unipartdigital/tail-anchor-hardware/README.md

# tail-anchor-hardware

Standalone anchor for tail

See https://github.com/unipartdigital/tail for more details
