unipartdigital/tail-anchor-hardware/v1/3d/ARJP11A_ARJP11A-MA.step

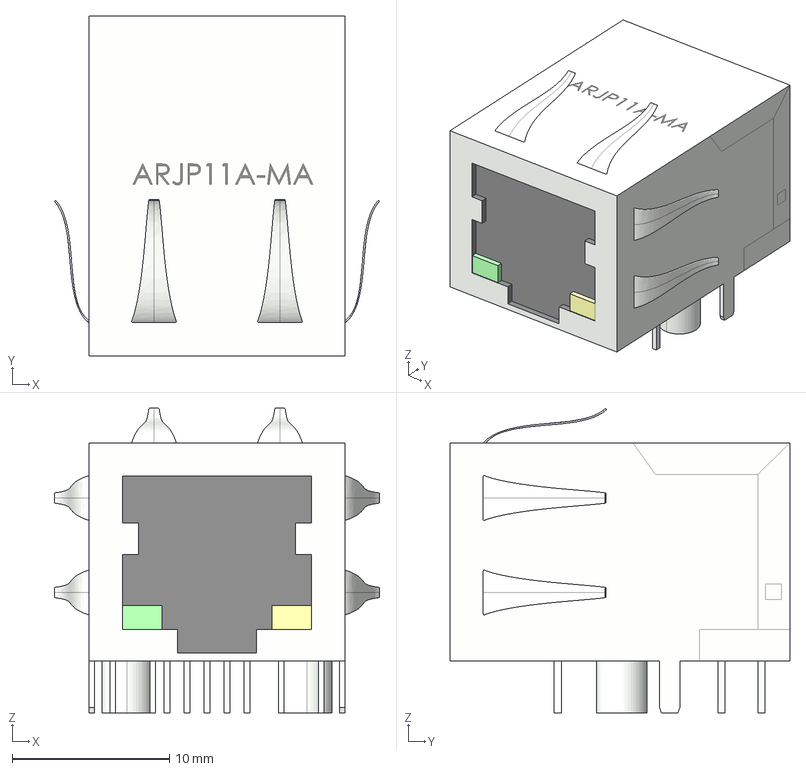
[picture p1: CAD file, 2020-07-31]
v1/3d/ARJP11A_ARJP11A-MA.step
20.7 x 21.6 x 19.3 mm
