unipartdigital/tail-anchor-hardware/(list of files, cad)

Other CAD files:
v1/3d/ARJP11A_ARJP11A-MB.step
