unipartdigital/tail-anchor-hardware/v1/tail-anchor-hardware.pdf

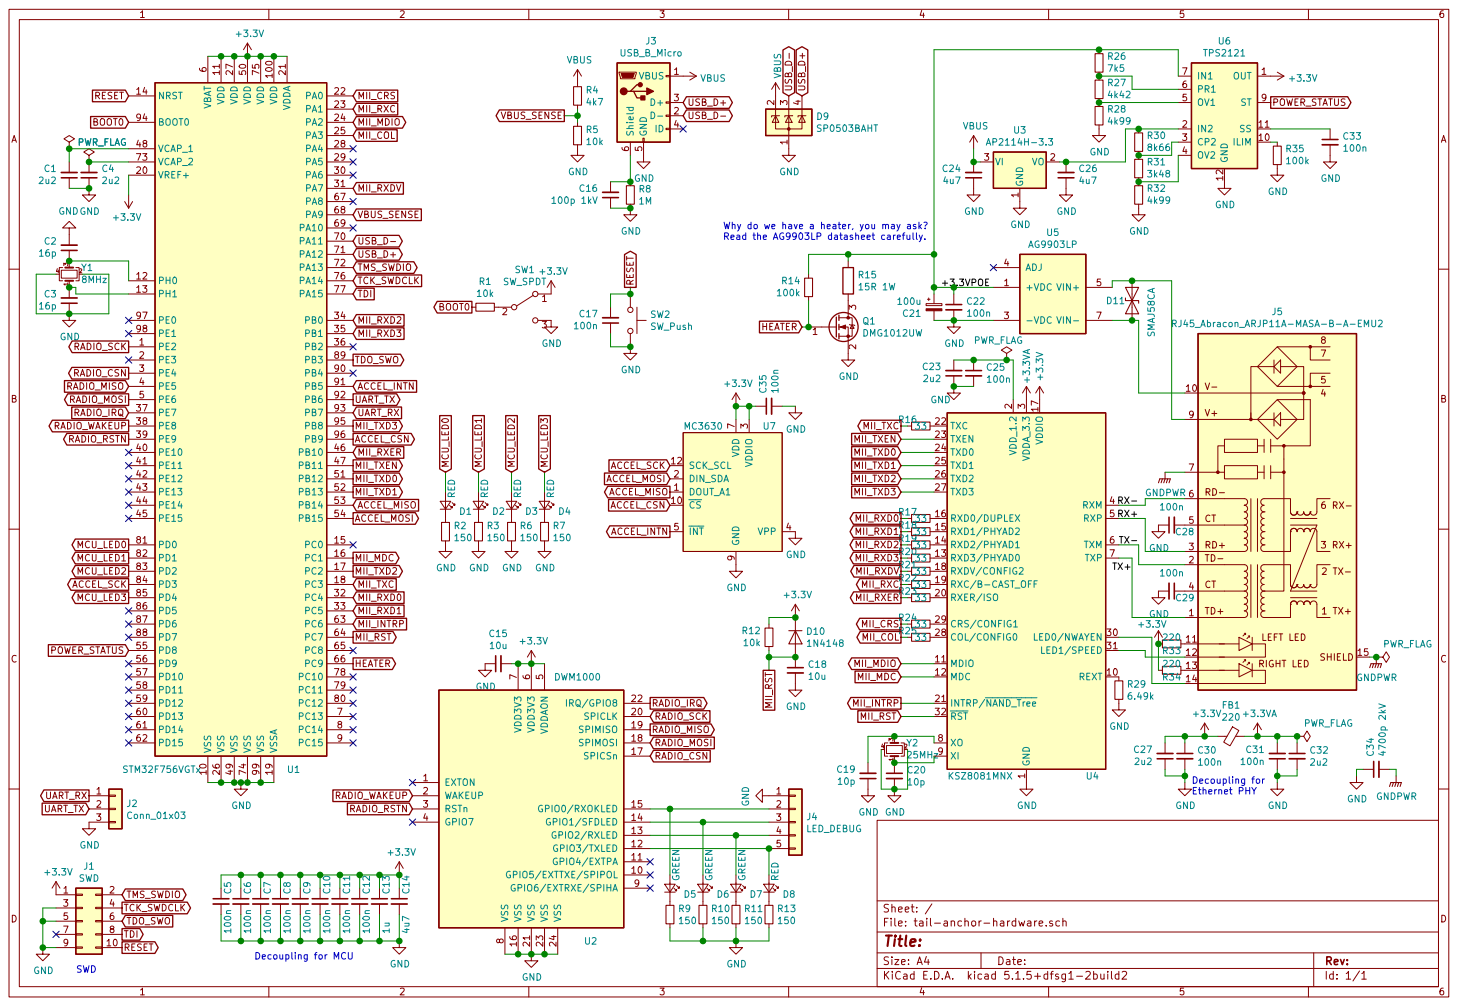
[picture p2: page 1]

6 VCAP_1 48 VCAP_2 73 VDD 100 VDD 11 VDD 27 VDD 50 VDD 75 VDDA 21 VREF+ 20 VSS 10 VSS 26 VSS 49 VSS 74 VSS 99 VSSA

Read the AG9903LP datasheet carefully.

1 REXT 10 MDIO 11 MDC 12 RXD1/PHYAD2 15 RXD0/DUPLEX 16 VDDIO 17 RXDV/CONFIG2 18 RXC/B-CAST_OFF 19 VDD_1.2

R33 12
220

Decoupling for Ethernet PHY

Id: 1/1 Title: File: tail-anchor-hardware.sch Sheet: / GND
