unipartdigital/tail-anchor-hardware/v1/tail-anchor-hardware.kicad_pcb

## KiCad design v1/tail-anchor-hardware.kicad_pcb (2020-07-31)

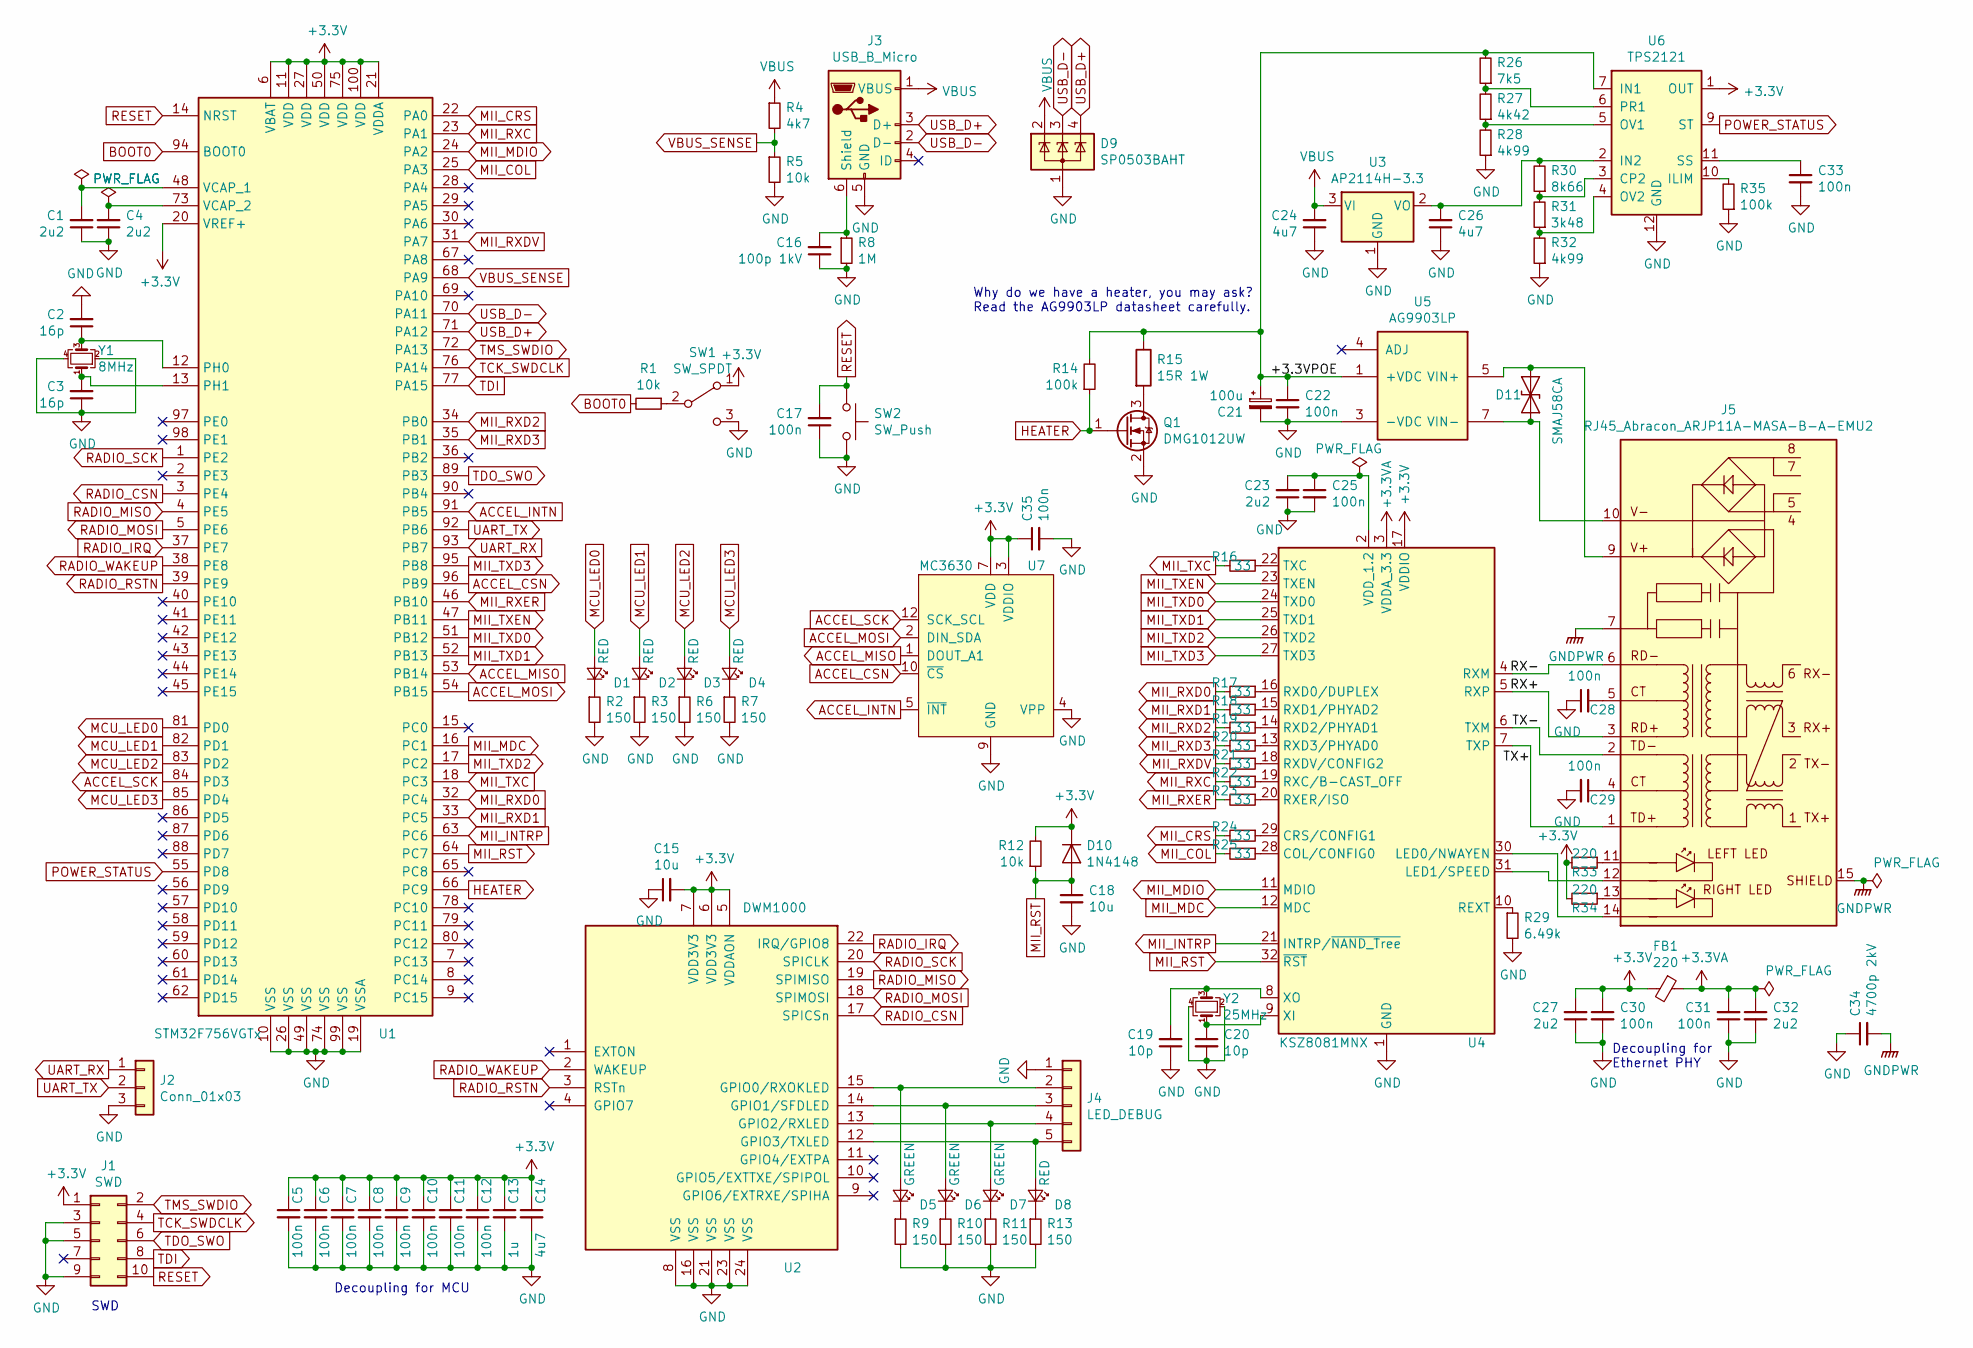
[picture p3: schematic tail-anchor-hardware.sch]

Parts:
C1, C4, C23, C27, C32: 2u2; C_0402_1005Metric; MPN GRM155R60J225ME95D
C2, C3: 16p; C_0402_1005Metric; MPN GJM1555C1H160GB01D
C5, C6, C7, C8, C9, C10, C11, C12, C17, C22, C25, C28, C29, C30, C31, C33, C35: 100n; C_0402_1005Metric; MPN MC0402X104K6R3CT
C13: 1u; C_0402_1005Metric; MPN CL05A105KQ5NNNC
C14, C24, C26: 4u7; C_0402_1005Metric; MPN GRM155R60G475ME87D
C15, C18: 10u; C_0402_1005Metric; MPN GRM155R60J106ME44D
C16: 100p 1kV; C_1206_3216Metric; MPN C1206C101JDGACAUTO
C19, C20: 10p; C_0402_1005Metric; MPN MCMT15N100F100CT
C21: 100u; C_Elec_5x5.8; MPN VZT101M1CTR-0506
C34: 4700p 2kV; C_1812_4532Metric; MPN C1812C472KGRACTU
D1, D2, D3, D4, D8: RED; LED_0603_1608Metric; MPN KP-1608SURCK
D5, D6, D7: GREEN; LED_0603_1608Metric; MPN KP-1608CGCK
D9: SP0503BAHT; SOT-143; MPN SP0503BAHTG
D10: 1N4148; D_SOD-123; MPN 1N4148W+
D11: SMAJ58CA; D_SMA; MPN SMAJ58CA
FB1: 220; L_0402_1005Metric; MPN BLM15AG221SN1D
J1: SWD; PinHeader_2x05_P1.27mm_Vertical_SMD; MPN FTSH-105-01-L-DV
J2: Conn_01x03; PinHeader_1x03_P2.54mm_Horizontal; MPN MC34747
J3: USB_B_Micro; USB_Micro-B_Molex_47346-0001; MPN 47346-0001
J4: LED_DEBUG; PinHeader_1x05_P2.54mm_Vertical; MPN 2211S-05G
J5: RJ45_Abracon_ARJP11A-MASA-B-A-EMU2; RJ45_Abracon_ARJP11A-MA_Horizontal; MPN ARJP11A-MASA-B-A-EMU2
Q1: DMG1012UW; SOT-323_SC-70; MPN DMG1012UW
R1, R5, R12: 10k; R_0402_1005Metric; MPN MCWR04X1002FTL
R2, R3, R6, R7, R9, R10, R11, R13: 150; R_0402_1005Metric; MPN MCWR04X1500FTL
R4: 4k7; R_0402_1005Metric; MPN MCWR04X4701FTL
R8: 1M; R_2010_5025Metric; MPN MCHVR0AJTEU1004
R14, R35: 100k; R_0402_1005Metric; MPN MCWR04X1003FTL
R15: 15R 1W; R_MELF_MMB-0207; MPN SMA-A0207FTDT15R
R16, R17, R18, R19, R20, R21, R22, R23, R24, R25: 33; R_0402_1005Metric; MPN CRG0402F33R
R26: 7k5; R_0402_1005Metric; MPN MCWR04X7501FTL
R27: 4k42; R_0402_1005Metric; MPN MCMR04X4421FTL
R28, R32: 4k99; R_0402_1005Metric; MPN MCWR04X4991FTL
R29: 6.49k; R_0402_1005Metric; MPN MCWR04X6491FTL
R30: 8k66; R_0402_1005Metric; MPN MCWR04X8661FTL
R31: 3k48; R_0402_1005Metric; MPN MC00625W040213K48
R33, R34: 220; R_0402_1005Metric; MPN MCWR04X2200FTL
SW1: SW_SPDT; SW_Slide_1P2T_CK_OS102011MS2Q; MPN OS102011MA1QN1C
SW2: SW_Push; SW_Tactile_SPST_Angled_PTS645Vx58-2LFS; MPN 1825027-8
U1: STM32F756VGTx; LQFP-100_14x14mm_P0.5mm; MPN STM32F756VGT6
U2: DWM1000; MPN DWM1000
U3: AP2114H-3.3; SOT-223-3_TabPin2; MPN AP2114H-3.3TRG1
U4: KSZ8081MNX; QFN-32-1EP_5x5mm_P0.5mm_EP3.45x3.45mm; MPN KSZ8081MNXIA
U5: AG9903LP; AG9900LP; MPN Ag9903LP
U6: TPS2121; Texas_VQFN-HR-12_2x2.5mm_P0.5mm; MPN TPS2121RUXR
U7: MC3630; LGA-12_2x2mm_P0.5mm; MPN MC3630
Y1: 8MHz; Crystal_SMD_5032-4Pin_5.0x3.2mm; MPN MCSJK-7I-8.00-18-10-60-B-10
Y2: 25MHz; Crystal_SMD_3225-4Pin_3.2x2.5mm; MPN MCSJK-7U-25.00-10-30-60-B-30

Connections:
+3.3VA: C31.2, C32.1, FB1.1, U4.3 (VDDA_3.3)
+3V3: C5.1, C6.1, C7.1, C8.1, C9.1, C10.1, C11.1, C12.1, C13.1, C14.1, C15.2, C27.2, C30.1, C35.1, D10.1 (K), FB1.2, J1.1, R12.2, R33.2, R34.2, SW1.1 (A), U1.6 (VBAT), U1.11 (VDD), U1.20 (VREF+), U1.21 (VDDA), U1.27 (VDD), U1.50 (VDD), U1.75 (VDD), U1.100 (VDD), U2.5 (VDDAON), U2.6 (VDD3V3), U2.7 (VDD3V3), U4.17 (VDDIO), U6.1 (OUT), U6.8 (OUT), U7.3 (VDDIO), U7.7 (VDD)
/+3.3VPOE: C21.1, C22.1, R14.2, R15.1, R26.2, U5.1 (+VDC), U5.2 (+VDC), U6.7 (IN1)
/RX+: J5.3 (RD+), U4.5 (RXP)
/RX-: J5.6 (RD-), U4.4 (RXM)
/TX+: J5.1 (TD+), U4.7 (TXP)
/TX-: J5.2 (TD-), U4.6 (TXM)
ACCEL_CSN: U1.96 (PB9), U7.10 (~CS)
ACCEL_INTN: U1.91 (PB5), U7.5 (~INT)
ACCEL_MISO: U1.53 (PB14), U7.1 (DOUT_A1)
ACCEL_MOSI: U1.54 (PB15), U7.2 (DIN_SDA)
ACCEL_SCK: U1.84 (PD3), U7.12 (SCK_SCL)
BOOT0: R1.2, U1.94 (BOOT0)
GND: C1.1, C2.2, C3.1, C4.1, C5.2, C6.2, C7.2, C8.2, C9.2, C10.2, C11.2, C12.2, C13.2, C14.2, C15.1, C16.1, C17.1, C18.2, C19.1, C20.2, C21.2, C22.2, C23.1, C24.1, C25.2, C26.1, C27.1, C28.1, C29.2, C30.2, C31.1, C32.2, C33.2, C34.1, C35.2, D9.1 (A), J1.3, J1.5, J1.9, J2.3, J3.5 (GND), J4.1, Q1.2 (S), R2.2, R3.2, R5.2, R6.2, R7.2, R8.2, R9.2, R10.2, R11.2, R13.2, R28.1, R29.2, R32.1, R35.1, SW1.3 (C), SW2.2, U1.10 (VSS), U1.19 (VSSA), U1.26 (VSS), U1.49 (VSS), U1.74 (VSS), U1.99 (VSS), U2.8 (VSS), U2.16 (VSS), U2.21 (VSS), U2.23 (VSS), U2.24 (VSS), U3.1 (GND), U4.1 (GND), U4.33 (GND), U5.3 (-VDC), U6.12 (GND), U7.4 (VPP), U7.9 (GND), Y1.2, Y1.4, Y2.2, Y2.4
GNDPWR: C34.2, J5.7, J5.15 (SHIELD)
HEATER: Q1.1 (G), R14.1, U1.66 (PC9)
MCU_LED0: D1.2 (A), U1.81 (PD0)
MCU_LED1: D2.2 (A), U1.82 (PD1)
MCU_LED2: D3.2 (A), U1.83 (PD2)
MCU_LED3: D4.2 (A), U1.85 (PD4)
MII_COL: R25.2, U1.25 (PA3)
MII_CRS: R24.2, U1.22 (PA0)
MII_INTRP: U1.63 (PC6), U4.21 (INTRP/~NAND_Tree)
MII_MDC: U1.16 (PC1), U4.12 (MDC)
MII_MDIO: U1.24 (PA2), U4.11 (MDIO)
MII_RST: C18.1, D10.2 (A), R12.1, U1.64 (PC7), U4.32 (~RST)
MII_RXC: R22.2, U1.23 (PA1)
MII_RXD0: R17.2, U1.32 (PC4)
MII_RXD1: R18.2, U1.33 (PC5)
MII_RXD2: R19.2, U1.34 (PB0)
MII_RXD3: R20.2, U1.35 (PB1)
MII_RXDV: R21.2, U1.31 (PA7)
MII_RXER: R23.2, U1.46 (PB10)
MII_TXC: R16.2, U1.18 (PC3)
MII_TXD0: U1.51 (PB12), U4.24 (TXD0)
MII_TXD1: U1.52 (PB13), U4.25 (TXD1)
MII_TXD2: U1.17 (PC2), U4.26 (TXD2)
MII_TXD3: U1.95 (PB8), U4.27 (TXD3)
MII_TXEN: U1.47 (PB11), U4.23 (TXEN)
unnamed: C1.2, U1.48 (VCAP_1)
unnamed: C2.1, U1.12 (PH0), Y1.3
unnamed: C3.2, U1.13 (PH1), Y1.1
unnamed: C4.2, U1.73 (VCAP_2)
unnamed: C16.2, J3.6 (Shield), R8.1
unnamed: C19.2, U4.8 (XO), Y2.3
unnamed: C20.1, U4.9 (XI), Y2.1
unnamed: C23.2, C25.1, U4.2 (VDD_1.2)
unnamed: C26.2, R30.2, U3.2 (VO), U6.2 (IN2)
unnamed: C28.2, J5.5 (CT)
unnamed: C29.1, J5.4 (CT)
unnamed: C33.1, U6.11 (SS)
unnamed: D1.1 (K), R2.1
unnamed: D2.1 (K), R3.1
unnamed: D3.1 (K), R6.1
unnamed: D4.1 (K), R7.1
unnamed: D5.1 (K), R9.1
unnamed: D5.2 (A), J4.2, U2.15 (GPIO0/RXOKLED)
unnamed: D6.1 (K), R10.1
unnamed: D6.2 (A), J4.3, U2.14 (GPIO1/SFDLED)
unnamed: D7.1 (K), R11.1
unnamed: D7.2 (A), J4.4, U2.13 (GPIO2/RXLED)
unnamed: D8.1 (K), R13.1
unnamed: D8.2 (A), J4.5, U2.12 (GPIO3/TXLED)
unnamed: D11.1 (A1), J5.9 (V+), U5.5 (VIN+), U5.6 (VIN+)
unnamed: D11.2 (A2), J5.10 (V-), U5.7 (VIN-), U5.8 (VIN-)
unnamed: J5.11 (LLED+), R33.1
unnamed: J5.12 (LLED-), U4.31 (LED1/SPEED)
unnamed: J5.13 (RLED+), R34.1
unnamed: J5.14 (RLED-), U4.30 (LED0/NWAYEN)
unnamed: Q1.3 (D), R15.2
unnamed: R1.1, SW1.2 (B)
unnamed: R16.1, U4.22 (TXC)
unnamed: R17.1, U4.16 (RXD0/DUPLEX)
unnamed: R18.1, U4.15 (RXD1/PHYAD2)
unnamed: R19.1, U4.14 (RXD2/PHYAD1)
unnamed: R20.1, U4.13 (RXD3/PHYAD0)
unnamed: R21.1, U4.18 (RXDV/CONFIG2)
unnamed: R22.1, U4.19 (RXC/B-CAST_OFF)
unnamed: R23.1, U4.20 (RXER/ISO)
unnamed: R24.1, U4.29 (CRS/CONFIG1)
unnamed: R25.1, U4.28 (COL/CONFIG0)
unnamed: R26.1, R27.2, U6.6 (PR1)
unnamed: R27.1, R28.2, U6.5 (OV1)
unnamed: R29.1, U4.10 (REXT)
unnamed: R30.1, R31.2, U6.3 (CP2)
unnamed: R31.1, R32.2, U6.4 (OV2)
unnamed: R35.2, U6.10 (ILIM)
POWER_STATUS: U1.55 (PD8), U6.9 (ST)
RADIO_CSN: U1.3 (PE4), U2.17 (SPICSn)
RADIO_IRQ: U1.37 (PE7), U2.22 (IRQ/GPIO8)
RADIO_MISO: U1.4 (PE5), U2.19 (SPIMISO)
RADIO_MOSI: U1.5 (PE6), U2.18 (SPIMOSI)
RADIO_RSTN: U1.39 (PE9), U2.3 (RSTn)
RADIO_SCK: U1.1 (PE2), U2.20 (SPICLK)
RADIO_WAKEUP: U1.38 (PE8), U2.2 (WAKEUP)
RESET: C17.2, J1.10, SW2.1, U1.14 (NRST)
TCK_SWDCLK: J1.4, U1.76 (PA14)
TDI: J1.8, U1.77 (PA15)
TDO_SWO: J1.6, U1.89 (PB3)
TMS_SWDIO: J1.2, U1.72 (PA13)
UART_RX: J2.1, U1.93 (PB7)
UART_TX: J2.2, U1.92 (PB6)
USB_D+: D9.4 (K), J3.3 (D+), U1.71 (PA12)
USB_D-: D9.3 (K), J3.2 (D-), U1.70 (PA11)
VBUS: C24.2, D9.2 (K), J3.1 (VBUS), R4.1, U3.3 (VI)
VBUS_SENSE: R4.2, R5.1, U1.68 (PA9)

Notes on the sheet:
SWD
Decoupling for Ethernet PHY
Decoupling for MCU
Why do we have a heater, you may ask? Read the AG9903LP datasheet carefully.

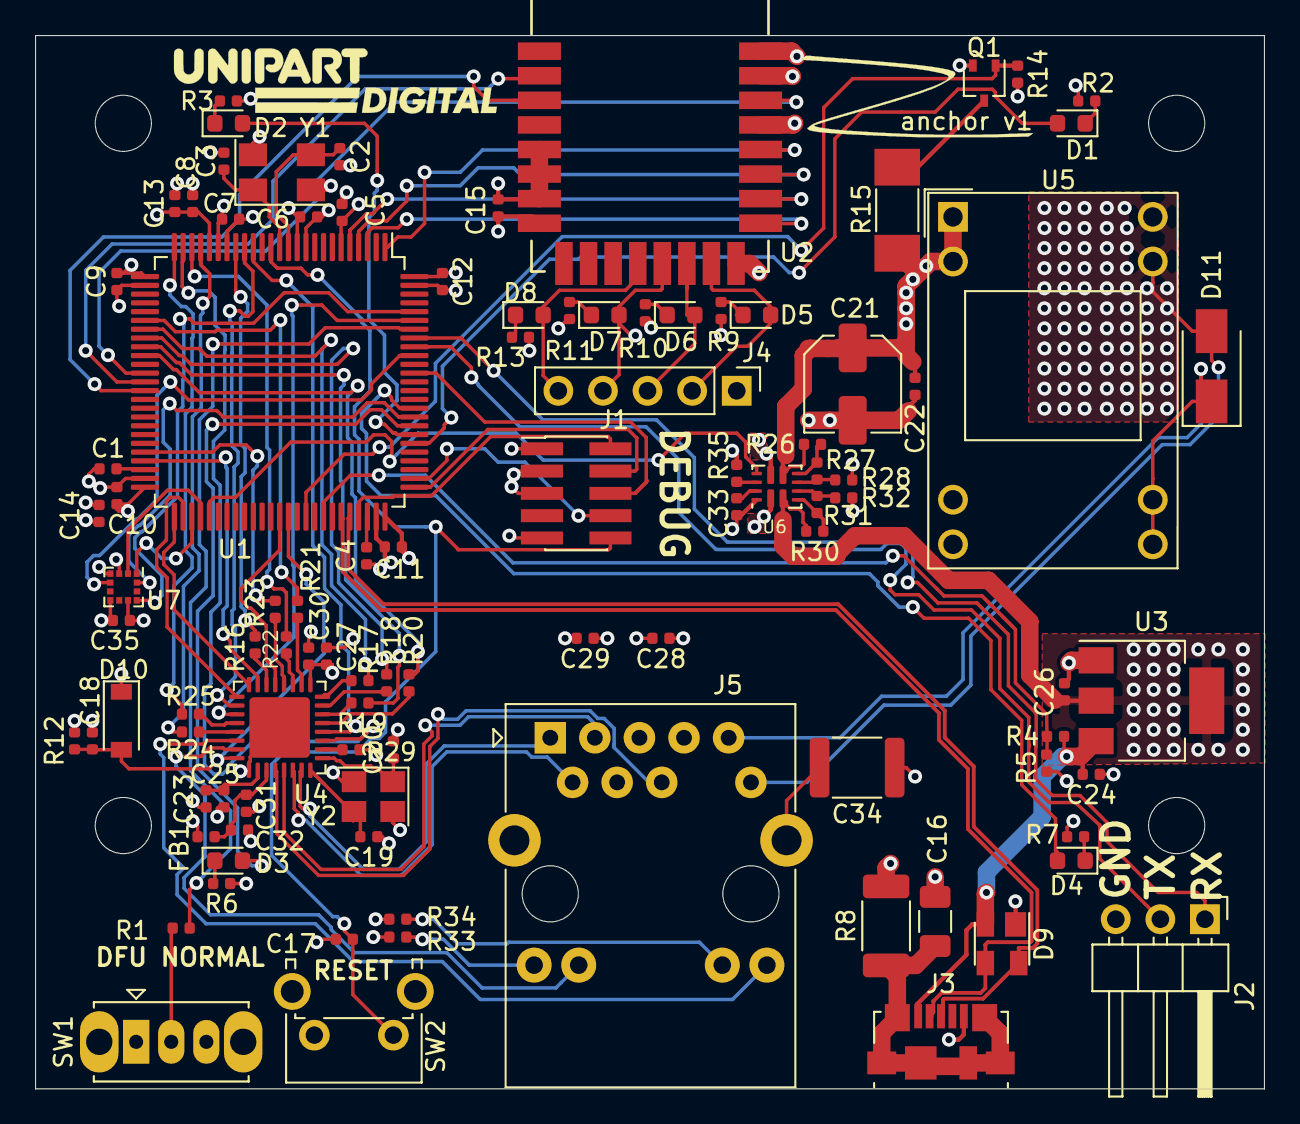
[picture p4: board tail-anchor-hardware.kicad_pcb from above]

Board: 4 copper layers, 70.0 x 60.0 mm, 99 parts (0 on the bottom side), 106 nets.
