unipartdigital/tail-anchor-hardware/(commit log)

2020-07-31 v1: Initial checkin of standalone anchor
    [ARJP11A_ARJP11A-MA.step, ARJP11A_ARJP11A-MB.step, tail-anchor-hardware-before-butchering.kicad_pcb, tail-anchor-hardware-before-even-more-butchering.kicad_pcb, tail-anchor-hardware.kicad_pcb, tail-anchor-hardware.sch]
2020-07-31 v1: remove extraneous files
    [tail-anchor-hardware-before-butchering.kicad_pcb, tail-anchor-hardware-before-even-more-butchering.kicad_pcb]
2020-07-31 v1: File to append to BOM for manufacturing
    This is necessary because KiCad doesn't yet know how to manage extra BOM
    items for mechanical parts.
    Simply cat this file to the end of the generated csv file before sending
    it off for manufacture.
    [tail-anchor-hardware-extra.csv]
